CUBoulder-2019Sp-IML4HCI/Final-Magic-Elevator-Funck-Polson/Flitwick_Spell_Training/data/magicLiftsBlurred.jpg

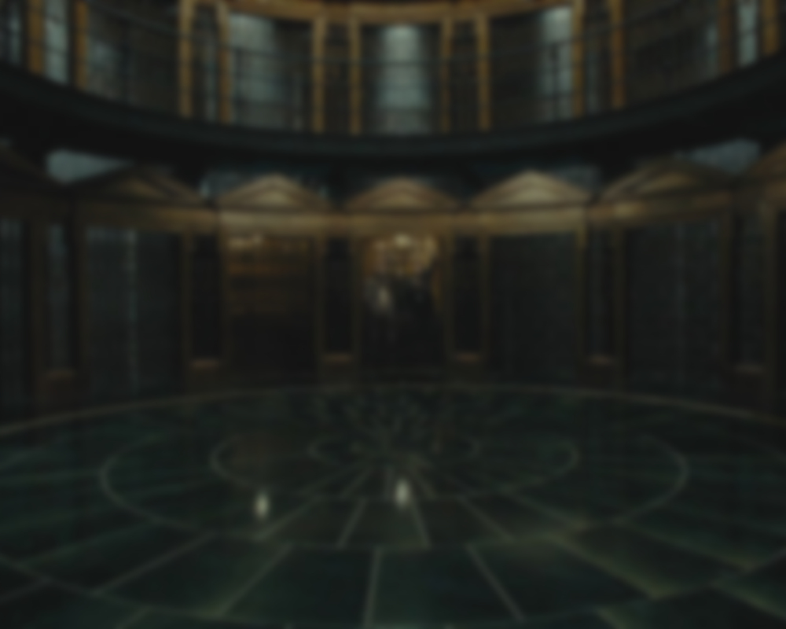
Flitwick_Spell_Training/data/magicLiftsBlurred.jpg
