CUBoulder-2019Sp-IML4HCI/Final-Magic-Elevator-Funck-Polson/Flitwick_Spell_Training/data/flitwickWandBlackBottom.jpg

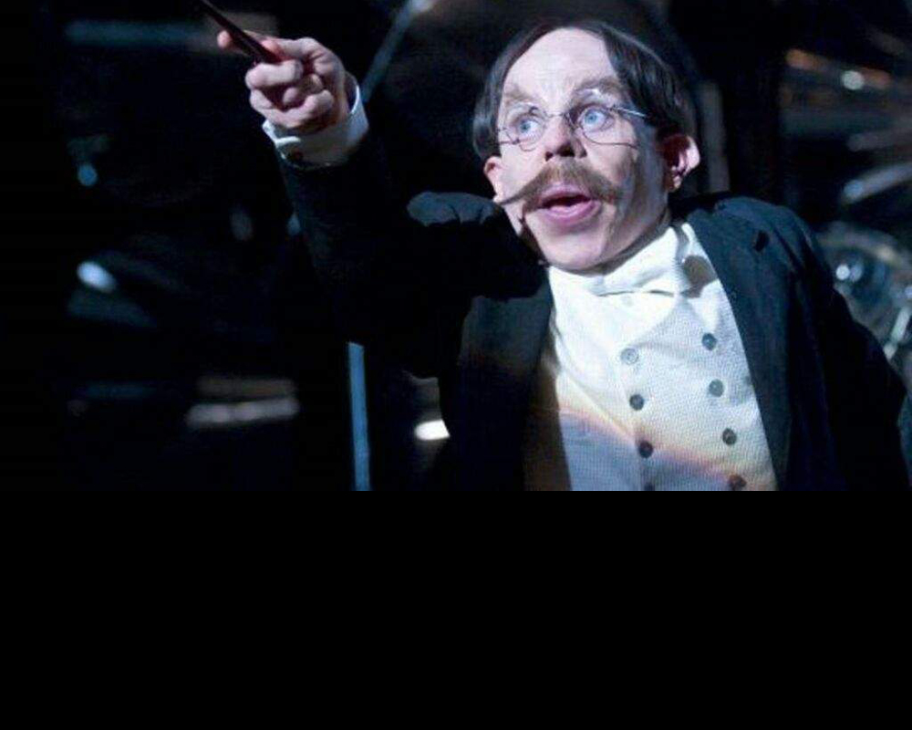
Flitwick_Spell_Training/data/flitwickWandBlackBottom.jpg
