CUBoulder-2019Sp-IML4HCI/Final-Magic-Elevator-Funck-Polson/Flitwick_Spell_Training/data/flitwickBlackBottom.jpg

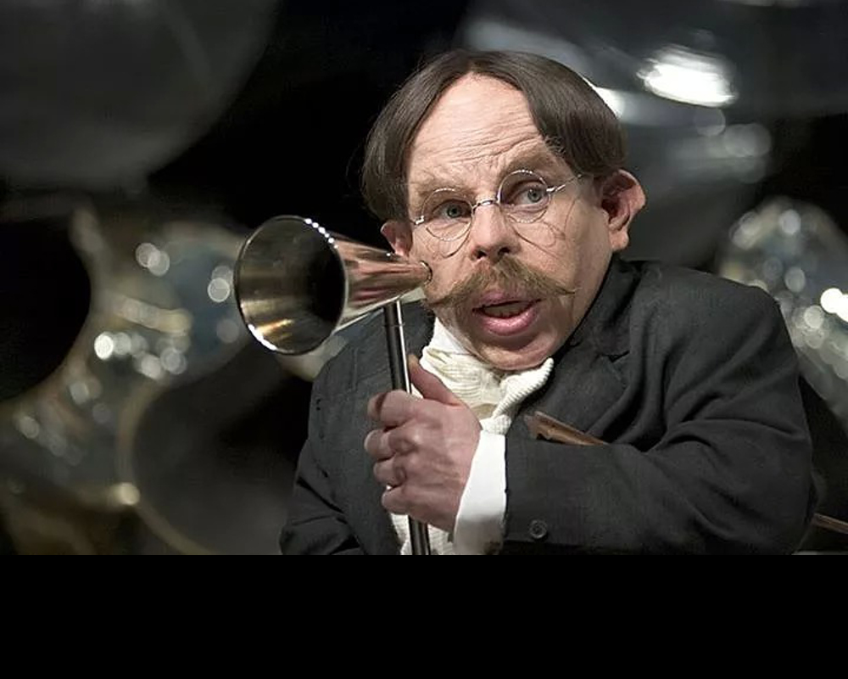
Flitwick_Spell_Training/data/flitwickBlackBottom.jpg
