CUBoulder-2019Sp-IML4HCI/Final-Magic-Elevator-Funck-Polson/(list of files, cad)

Other CAD files:
ElevatorAcrylicSheet.sldprt
