CUBoulder-2019Sp-IML4HCI/Final-Magic-Elevator-Funck-Polson/(threads)

Thread 2 (2019-04-24):

Magic Elevator Software

sapols, 2019-04-24:
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

bennytheshap, 2019-04-24:
This looks fun.

Also, there's a writer from a magazine who might want to interview you. Is that ok?

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

sapols, 2019-04-24:
I have no qualms talking to a magazine. I'd love to do an interview.

bennytheshap, 2019-04-24:
Cool.

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

sapols, 2019-04-25:
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

sapols, 2019-04-26:
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
