CUBoulder-2019Sp-IML4HCI/Final-Magic-Elevator-Funck-Polson/wand/py/wand_to_osc.py

# requires the following python libraries:
#  python-osc
#  pyserial

import serial
from pythonosc import udp_client

# change this string depending upon where your computer makes a device for the micro:bit
# ls /dev/cu.usbmodem*
serialport = "/dev/cu.usbmodem14202" # top right USB on my mac

ser = serial.Serial(serialport, 115200)
client = udp_client.SimpleUDPClient("localhost", 8999)

while(True):
	try:
	    line = ser.readline().decode('utf8').strip()

	    x, y, z = map(float, line.split("^"))

	    print(f"({x}, {y}, {z})")

	    client.send_message("/wand_accel", [x, y, z] )
	except: pass
