CUBoulder-2019Sp-IML4HCI/Final-Magic-Elevator-Funck-Polson/(commit log)

2019-03-15 Activate solenoids with cast spells
2019-03-19 Add a Wekinator model trained for wand-to-solenoid
    [currentData.csv]
2019-04-17 Change IP address to that of the raspberry pi
2019-04-17 Upload the skeleton of a motor control server
2019-04-17 Control motor position on OSC messages received
2019-04-17 Slightly improve printouts
2019-04-20 Trigger UP or DOWN gesture training with buttons
2019-04-20 Upload a Wekinator model trained for LEGO motor
    [currentData.csv]
2019-04-22 Hide buttons during training
2019-04-22 Preconfigured DTW model w/o up/down wand gestures
    [currentData.csv]
2019-04-23 Group code for raspberry pi into one directory
2019-04-25 Version of motor script that expects two users
2019-04-25 Set proper motor limits and positions
2019-04-25 final version of motor script expecting two users
2019-04-26 Final version of motor script expecting two people
